TheFuzzyGiggler/Ramalama-Idler-Redux/STLs/Idler Housing.stl

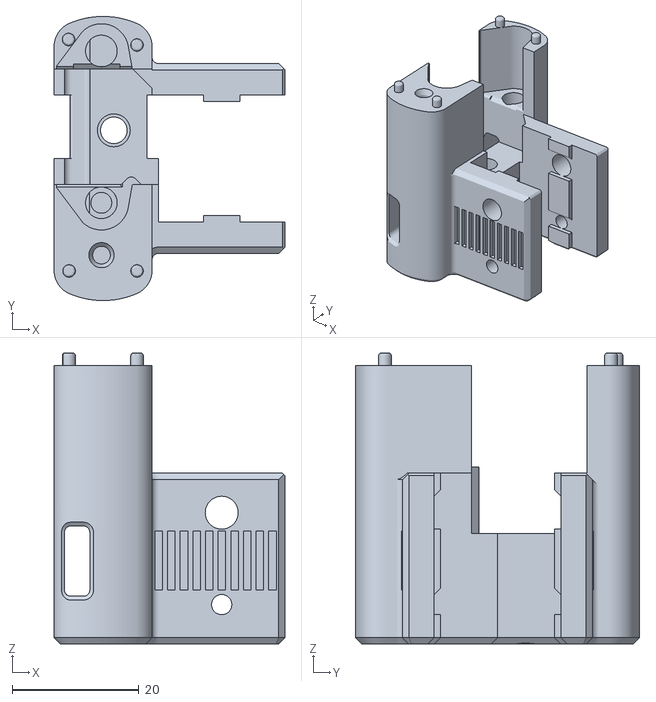
[picture p2: CAD file, 2023-04-24]
STLs/Idler Housing.stl
36.5 x 44.9 x 46.0
