TheFuzzyGiggler/Ramalama-Idler-Redux/STLs/Idler.stl

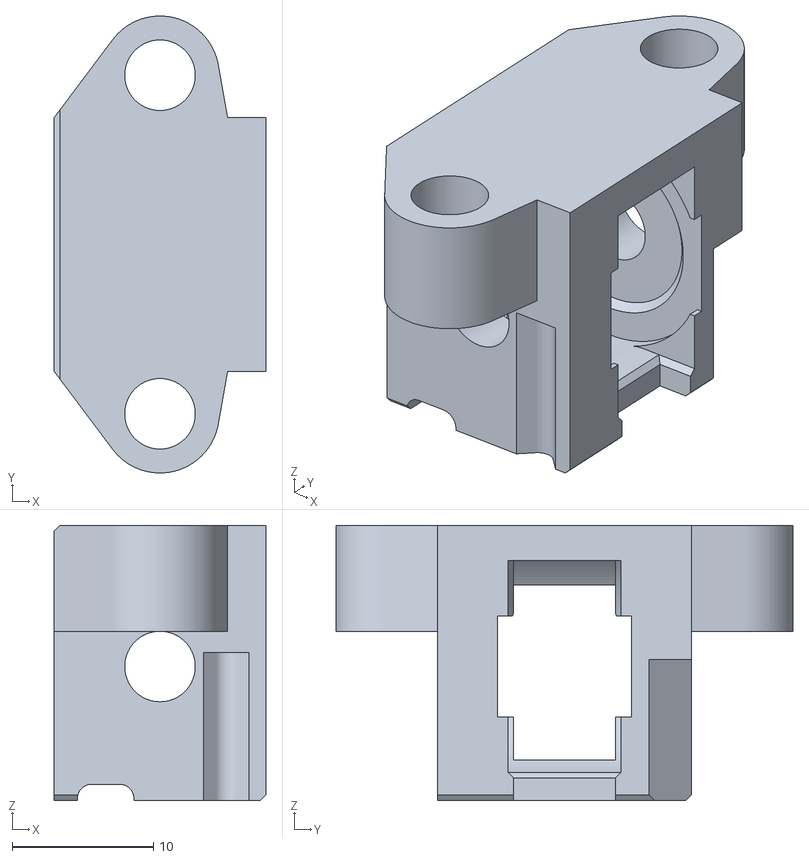
[picture p3: CAD file, 2023-04-24]
STLs/Idler.stl
15.0 x 32.4 x 19.5
