TheFuzzyGiggler/Ramalama-Idler-Redux/STLs/Idler Cover.stl

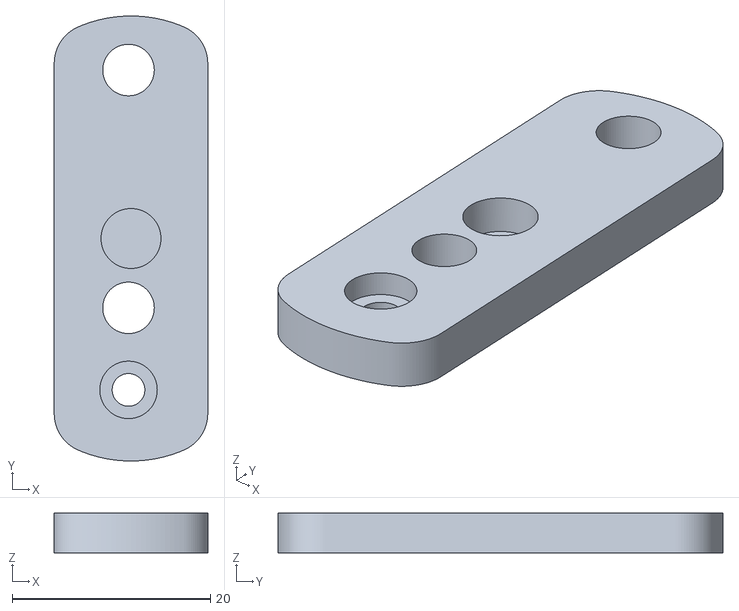
[picture p4: CAD file, 2023-04-24]
STLs/Idler Cover.stl
15.5 x 44.9 x 4.00
