TheFuzzyGiggler/Ramalama-Idler-Redux/(list of files, cad)

Other CAD files:
CAD/Rama Remix Idlers.f3d
